shop2007/MAK-NANO2RL-107/IN CONTENITORE METALLICO 114X65.jpg

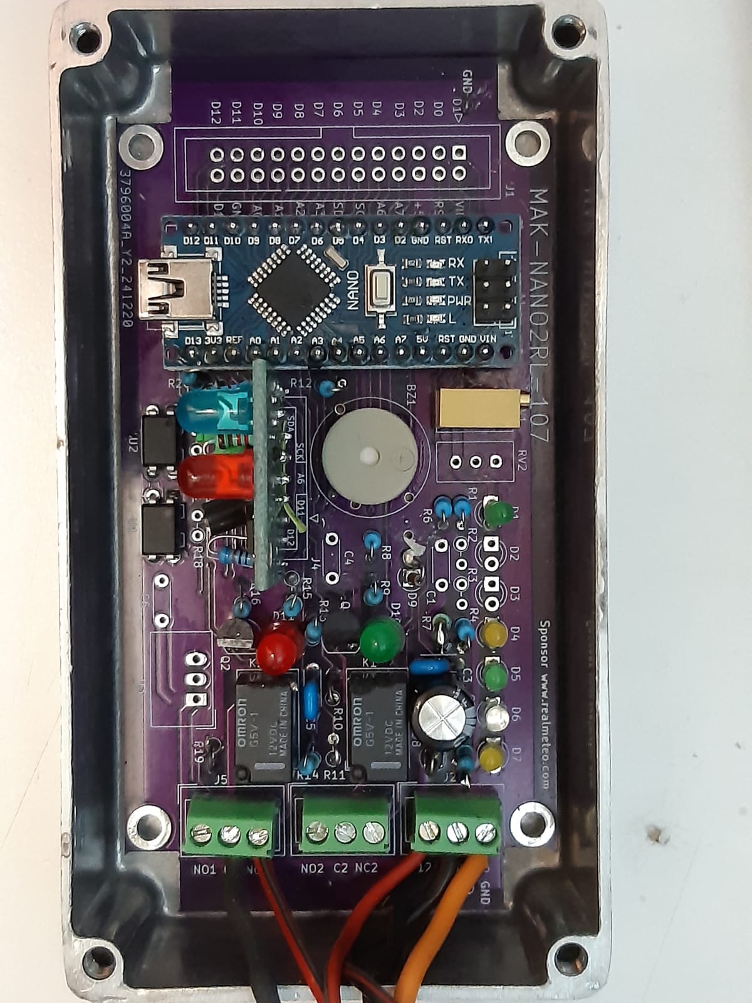
IN CONTENITORE METALLICO 114X65.jpg
