shop2007/MAK-NANO2RL-107/MKR-NANO2RL-107-2.jpg

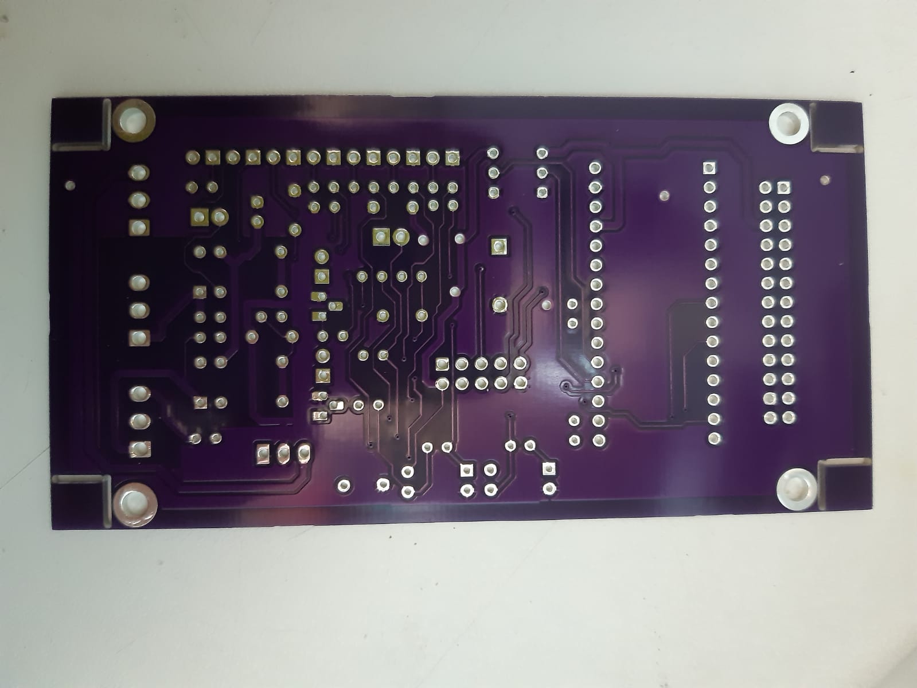
MKR-NANO2RL-107-2.jpg
