shop2007/MAK-NANO2RL-107/README.md

# MAK-NANO2RELE-107

Il pcb **MAK-NANO2RELE-107** è stato pensato per colmare una mancanza nel mondo delle BREAK-OUT, 
una scheda che consenta ai **MAKERS**, di realizzare piccoli sistemi senza dover cablare troppi pezzi, 
quali un Arduino **NANO**, una scheda con **2 RELE** con bobina isolata da fotoaccoppiatori, una scheda per il 5v, 
un buzzer, un modulo WATCHDOG32, ed un sensore di temperatura,con la possibilità di montare tutto su un supporto portaschede da guida din, standard **107** mm.
E' presente anche un connettore di tipo FLAT-CABLE dove possiamo trovare tutti i pin di NANO, per altre espansioni e connessioni
