shop2007/MAK-NANO2RL-107/immagini/1s-l1600.png

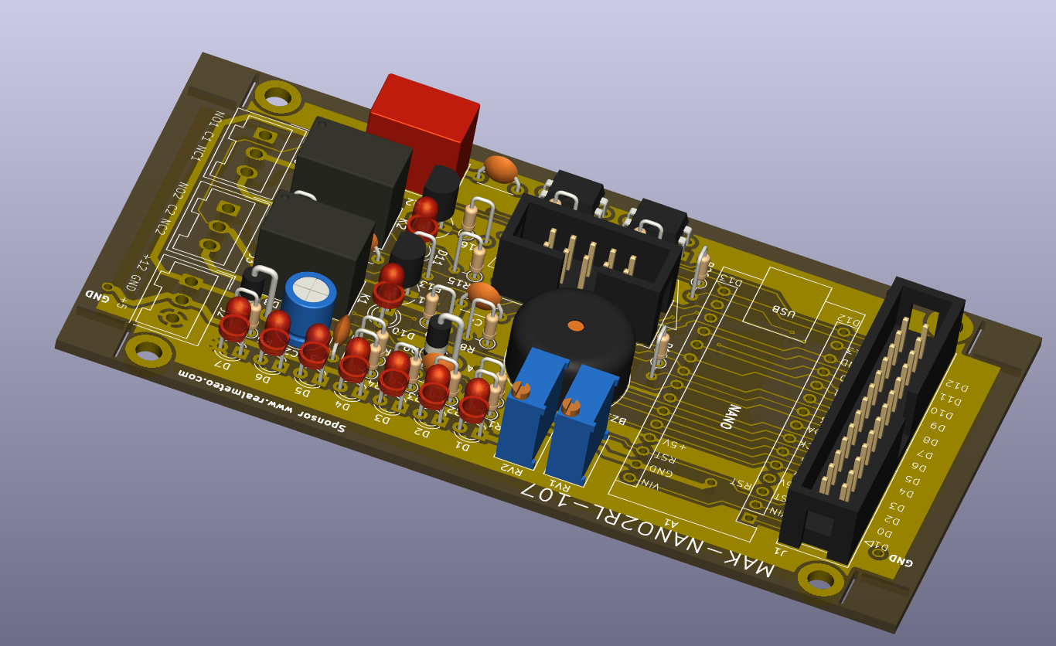
immagini/1s-l1600.png
