shop2007/MAK-NANO2RL-107/immagini/2s-l1600.png

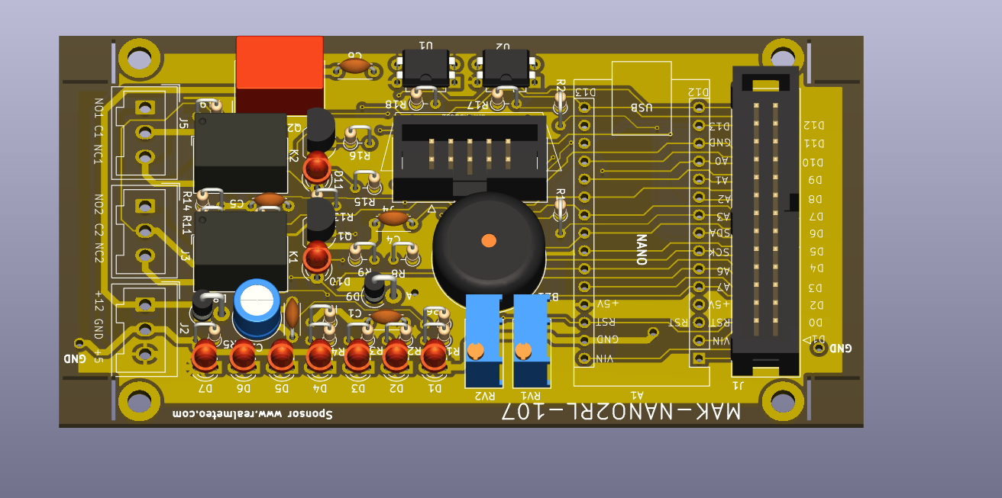
immagini/2s-l1600.png
