shop2007/MAK-NANO2RL-107/immagini/3s-l1600.png

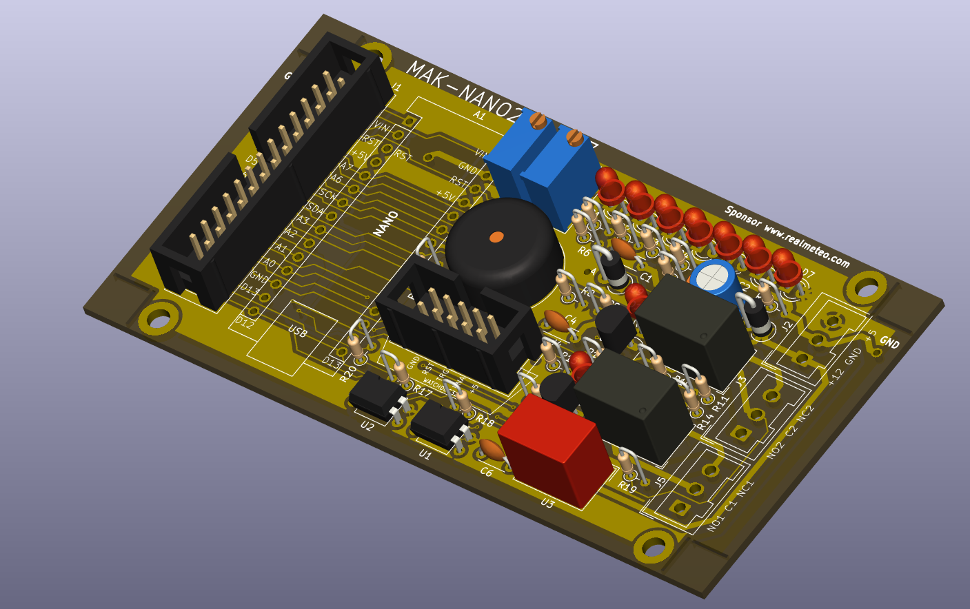
immagini/3s-l1600.png
