shop2007/MAK-NANO2RL-107/immagini/4s-l1600.png

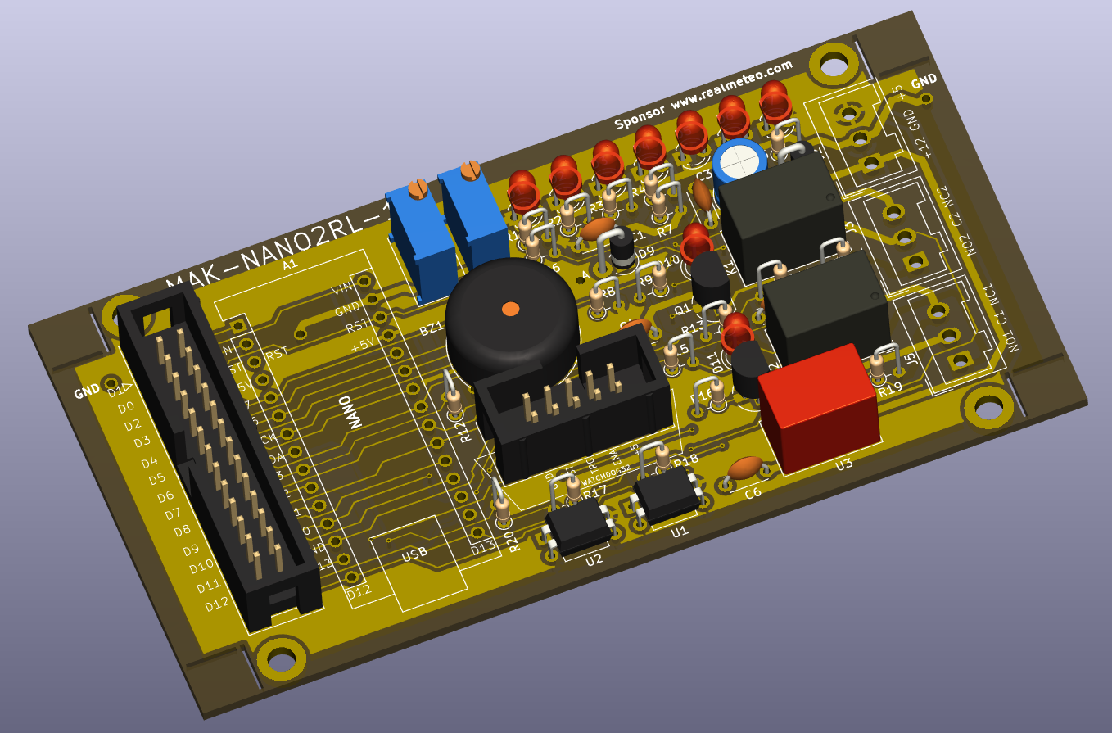
immagini/4s-l1600.png
