shop2007/MAK-NANO2RL-107/immagini/6s-l1600.png

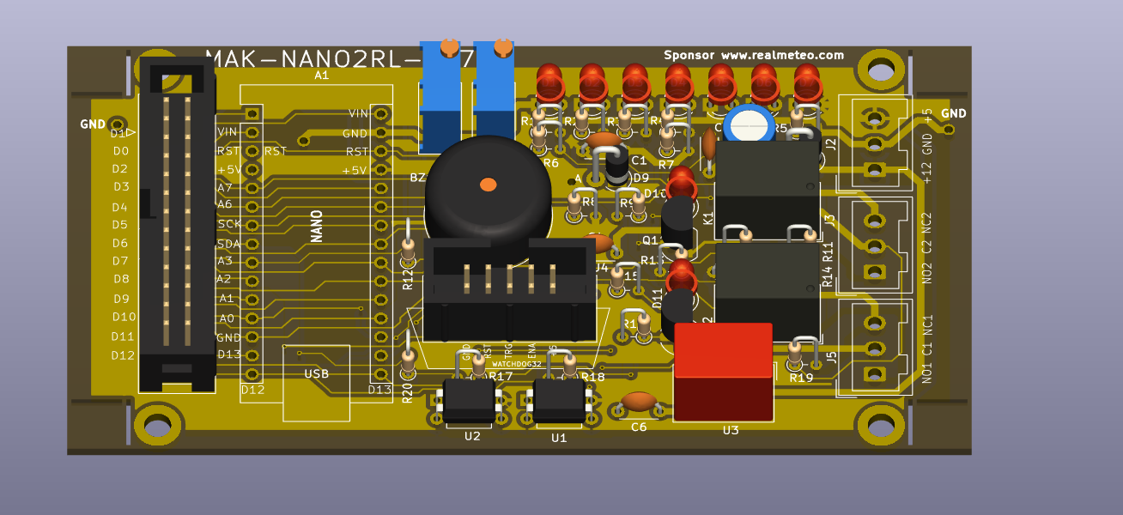
immagini/6s-l1600.png
