shop2007/MAK-NANO2RL-107/immagini/7s-l140.jpg

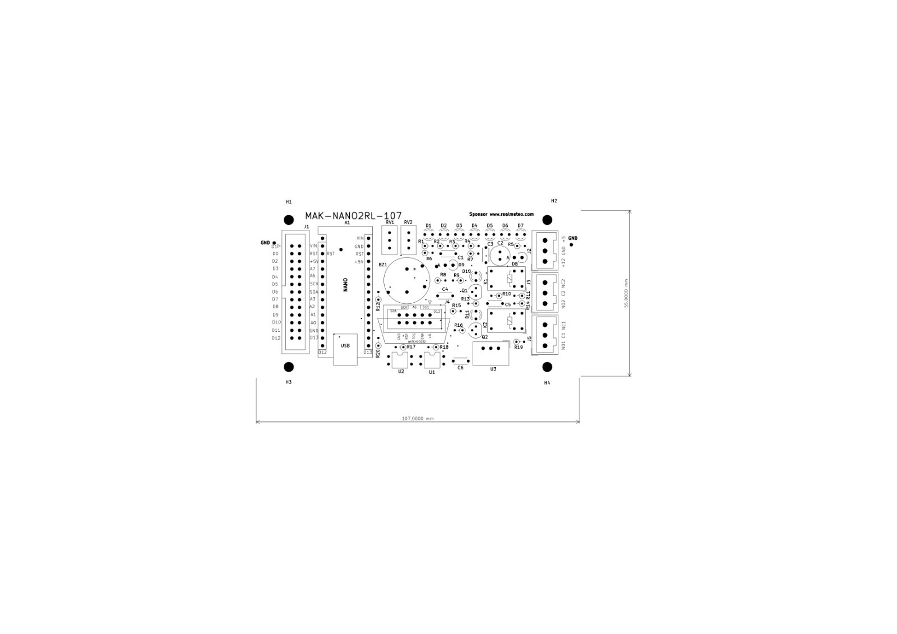
immagini/7s-l140.jpg
