shop2007/MAK-NANO2RL-107/immagini/86s-l1600.png

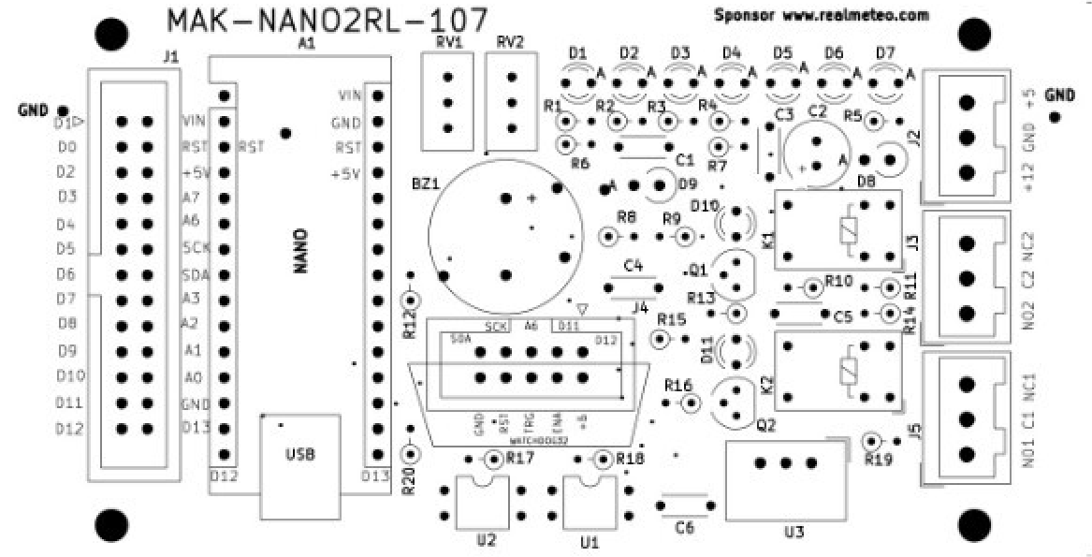
immagini/86s-l1600.png
