shop2007/MAK-NANO2RL-107/MAK-NANO2RL-107_schematic_kicad.pdf.jpg.png

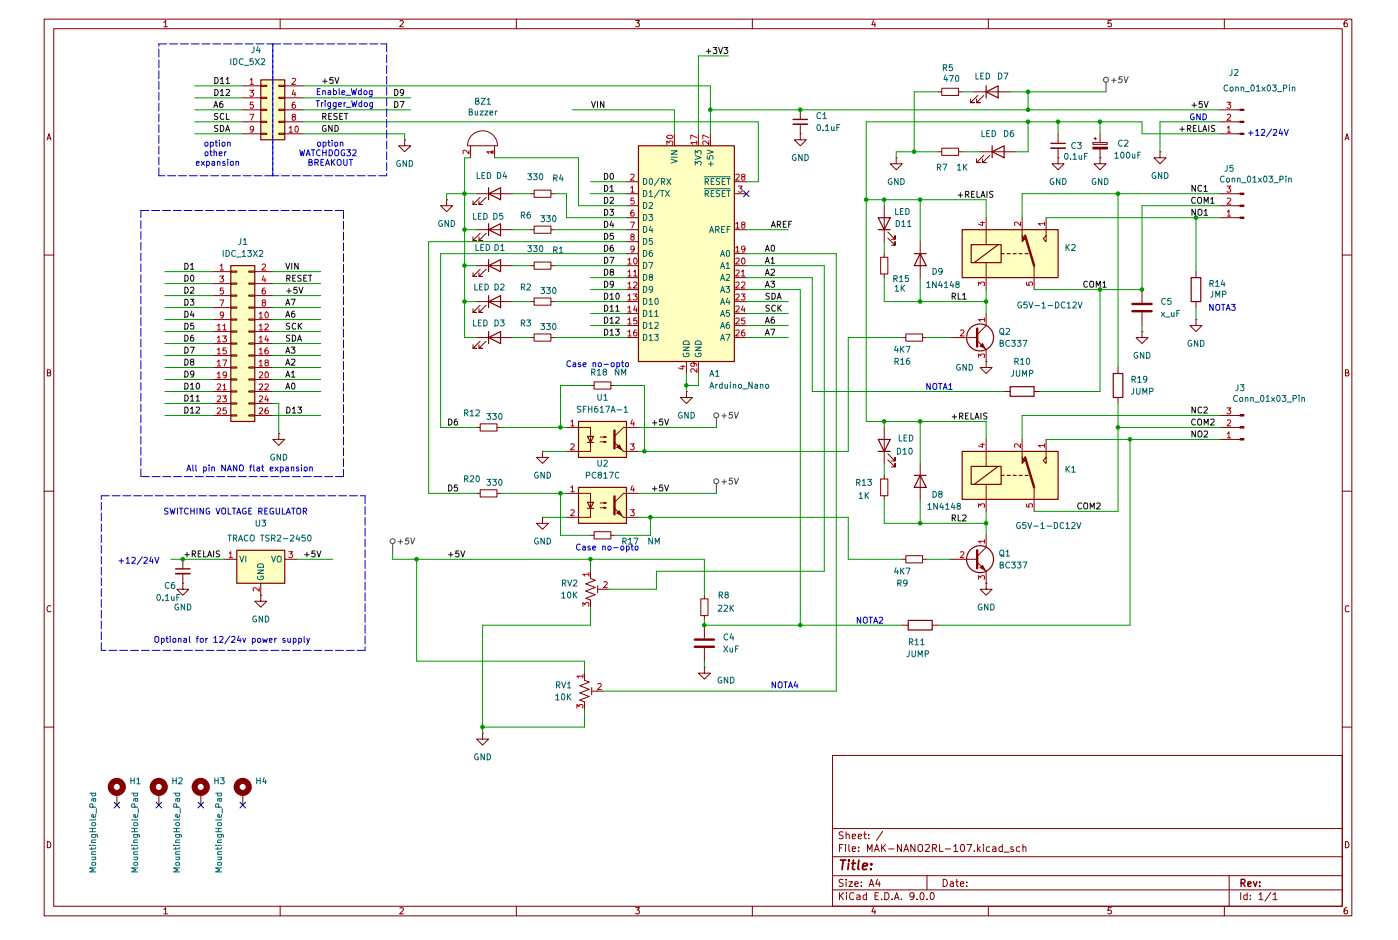
MAK-NANO2RL-107_schematic_kicad.pdf.jpg.png
