shop2007/MAK-NANO2RL-107/Rele-12v-3a-spdt-hk4100f-dc12v-shg.jpg

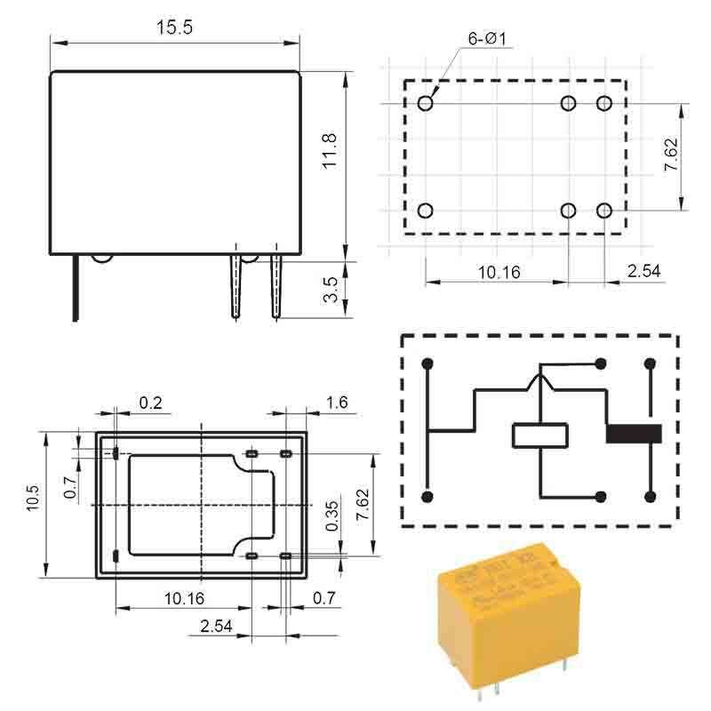
Rele-12v-3a-spdt-hk4100f-dc12v-shg.jpg
