shop2007/MAK-NANO2RL-107/watchdog32_breakout.jpg

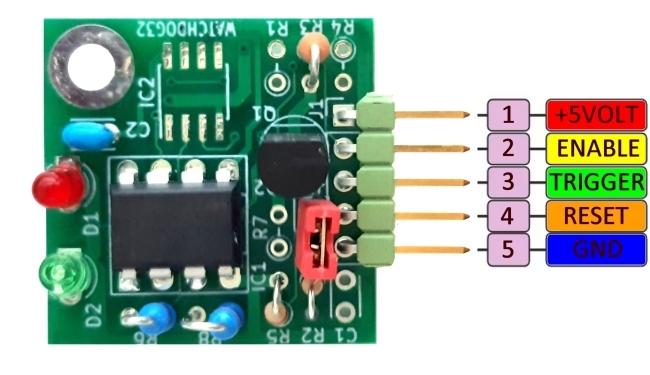
watchdog32_breakout.jpg
