shop2007/MAK-NANO2RL-107/MAK_NANO2RL-bom.xlsx

Reference | Value | Datasheet | Note | Qty | DNP
A1 | Arduino_Nano_v3.x | http://www.mouser.com/pdfdocs/Gravitech_Arduino_Nano3_0.pdf |  | 1
BZ1 | Buzzer | ~ |  | 1
C1,C3,C6 | 0.1uF | ceramico 50v |  | 3
C2 | 100uF | 35v |  | 1
C4 | XuF | 35v | Filtro opzionale | 1
C5 | 1uF | 35v |  | 1
D1,D2,D3,D4,D5,D6,D7,D10,D11 | LED | 3mm | colori vari da 3mm | 9
D8,D9 | 1N4148 | https://assets.nexperia.com/documents/data-sheet/1N4148_1N4448.pdf |  | 2
H1,H2,H3,H4 | Vite+dado M3 | ~ | Fissaggio colonnini | 4
J1 | Conn_02x13_Odd_Even | flat 13x2 | Ripete tutti i segnali di NANO | 1
J2,J3,J5 | Conn_01x03_Pin | Sourcingmap ZB350 AC300 V 10 A 3p passo 3.5 mm PCB morsettiera a vite |  | 3
J4 | Conn_02x05_Odd_Even | flat 5x2 | In alternativa alla WatchDog32 board | 1
K1,K2 | G5V-1 DC12 | http://www.hsinda.com.tw/upload/file/Y14-20200430135145.pdf |  | 2
Q1,Q2 | BC337 | https://diotec.com/tl_files/diotec/files/pdf/datasheets/bc337.pdf |  | 2
R1,R2,R3,R4,R6,R12,R20 | 330 | 1/4watt |  | 7
R5 | 470 | 1/4watt |  | 1
R7,R13,R15 | 1K | 1/4watt |  | 3
R8 | 22K | 1/4watt |  | 1
R9,R16 | 4K7 | 1/4watt |  | 2
R10,R11,R19 | JUMP | 1/4watt | montare se necessario | 3
R14 | JMP | 1/4watt |  | 1
R17,R18 | NM | 1/4watt | installare in alternativa agli opto U1 U2 | 2
RV1,RV2 | R_Potentiometer_Trim_US | Trimmer tarature varie, soglie |  | 2
U1,U2 | SFH617A-1 | http://www.vishay.com/docs/83740/sfh617a.pdf | opto comando relais | 2
U3 | TRACO TSR2-2450 | https://www.onsemi.cn/PowerSolutions/document/MC7800-D.PDF | regolatore switching 5v | 1
Box 120x65x40
