shop2007/MAK-NANO2RL-107/Montaggio scheda MAK-NANO2RL-107.docx

Montaggio scheda MAK-NANO2RL-107

Schema elettrico

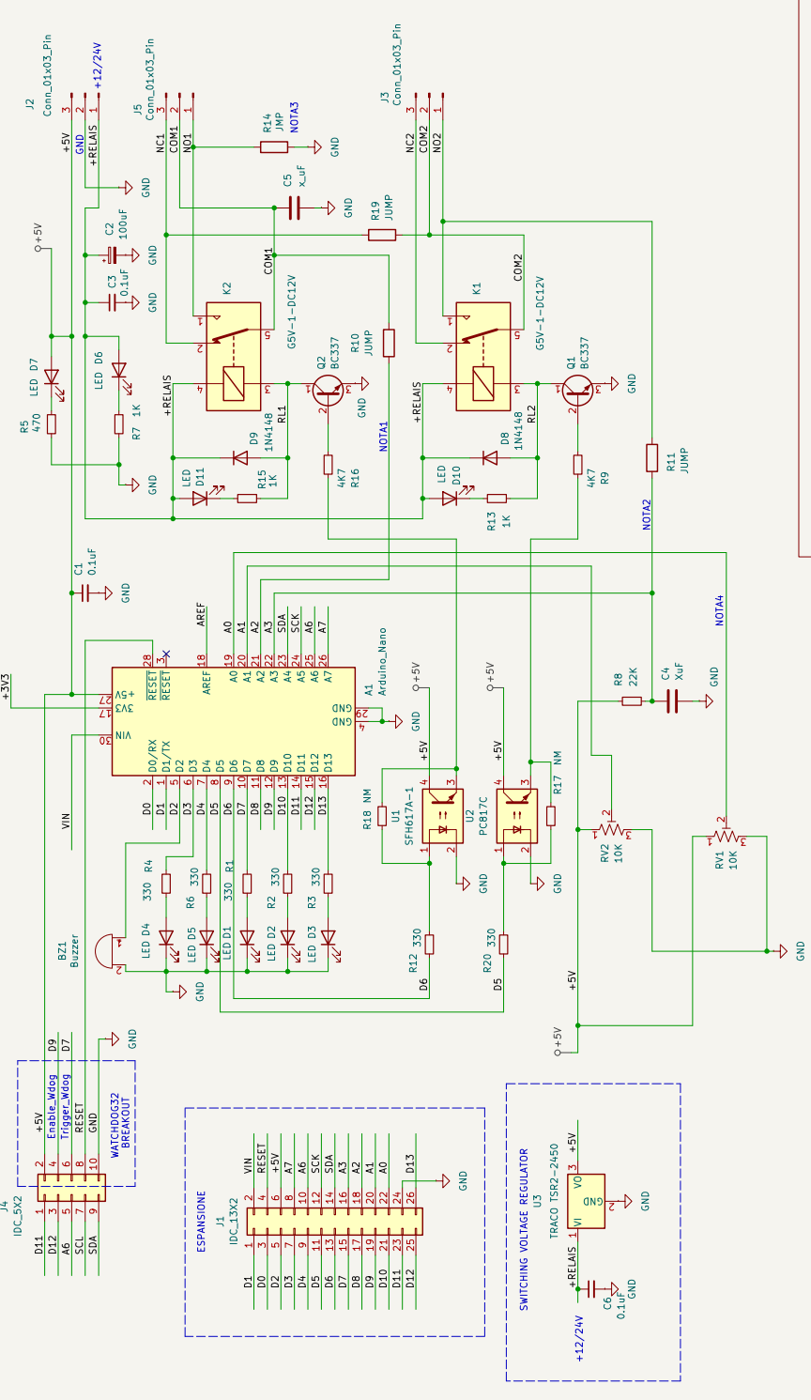
[picture p13: figure]
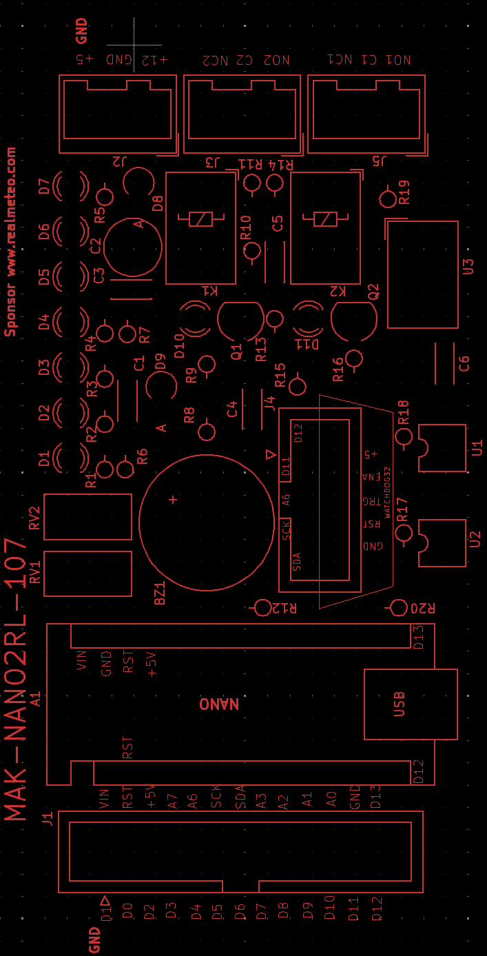
[picture p14: figure]

Reference | Value | | Footprint
A1 | Arduino_Nano | | Module:Arduino_Nano
BZ1 | Buzzer | | Buzzer_Beeper:Buzzer_15x7.5RM7.6
C1,C3,C6 | 0.1uF | | Capacitor_THT:C_Disc_D4.3mm_W1.9mm_P5.00mm
C2 | 100uF | | Capacitor_THT:C_Radial_D6.3mm_H7.0mm_P2.50mm
C4 | XuF optional | | Capacitor_THT:C_Disc_D4.3mm_W1.9mm_P5.00mm
C5 | 1uF optional | | Capacitor_THT:C_Disc_D4.3mm_W1.9mm_P5.00mm

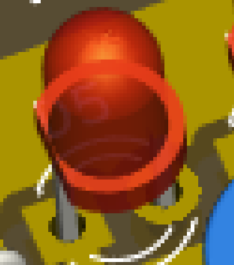
[picture p15: figure]

D1,D2,D3,D4,D5,D6, D7,D10,D11 | LED colori vari | | LED_THT:LED_D3.0mm Anodo pad tondo Katodo pad quadro

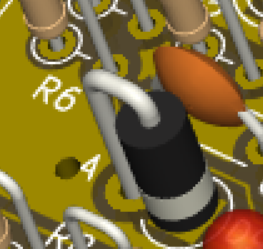
[picture p16: figure]

D8,D9 | 1N4148 | | Diode_THT:D_DO-41_SOD81_P2.54mm_Vertical_AnodeUp Anodo pad tondo Katodo pad quadro
H1,H2,H3,H4 | Vite+dado M3 | | MountingHole:MountingHole_3.2mm_M3_DIN965_Pad
J1 | Conn_02x13_ IDC | | Connector_IDC:IDC-Header_2x13_P2.54mm_Vertical
J2,J3,J5 | Conn_01x03_Pin | | Connector_Wago:Wago_734-133_1x03_P3.50mm_Vertical
J4 | Conn_02x05_ IDC WATCHDOG32 | | Connector_IDC:IDC-Header_2x05_P2.54mm_Vertical
K1,K2 | G5V-1 DC12 | | Relay_THT:Relay_SPDT_HsinDa_Y14 Y14x-1C-xxDS

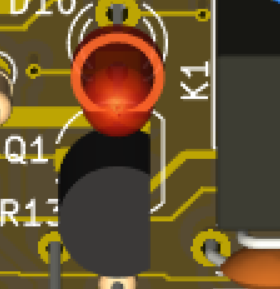
[picture p17: figure]

Q1,Q2 | BC337 | | Package_TO_SOT_THT:TO-92_
R1,R2,R3,R4,R6, R12,R20 | 330 - 1/4W | | Resistor_THT:R_Axial_DIN0204_L3.6mm_D1.6mm_P2.54mm_Vertical
R5 | 470 - 1/4W | | Resistor_THT:R_Axial_DIN0204_L3.6mm_D1.6mm_P2.54mm_Vertical
R7,R13,R15 | 1K - 1/4W | | Resistor_THT:R_Axial_DIN0204_L3.6mm_D1.6mm_P2.54mm_Vertical
R8 | 22K - 1/4W | | Resistor_THT:R_Axial_DIN0204_L3.6mm_D1.6mm_P2.54mm_Vertical
R9,R16 | 4K7 - 1/4W | | Resistor_THT:R_Axial_DIN0204_L3.6mm_D1.6mm_P2.54mm_Vertical
R10,R11,R19 | JUMP Optional | | Resistor_THT:R_Axial_DIN0204_L3.6mm_D1.6mm_P2.54mm_Vertical
R14 | JUMP Optional | | Resistor_THT:R_Axial_DIN0204_L3.6mm_D1.6mm_P2.54mm_Vertical
R17,R18 | N.M. Short opto | | Resistor_THT:R_Axial_DIN0204_L3.6mm_D1.6mm_P2.54mm_Vertical
RV1,RV2 | Trimmer 10K | | Potentiometer_THT:Potentiometer_Bourns_3296W_Vertical

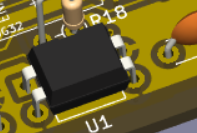
[picture p18: figure]

U1,U2 | SFH617A-1 PC817C | | Package_DIP:DIP-4_W7.62mm
U3 | TRACO TSR2-2450 optional | | Converter_DCDC:Converter_DCDC_TRACO_TSR-1_THT
Box 120x65x40 | box

BUZZER | PORT D2
LED D1 | PORT D7
LED D2 | PORT D10
LED D3 | PORT D13
LED D4 | PORT D3
LED D5 | PORT D4
LED D6 | SPIA +12v
LED D7 | SPIE +5v
LED D10 | SPIA RELAY NC/COM/NO2
LED D11 | SPIA RELAY NC/COM/NO1
A0 | TRIMMER 1
A1 | TRIMMER2
A2 | LETTURA COM1 (R10)
A3 | LETTURA NO2 (R11)
A4 | SDA
A5 | SCL
TRIGGER WATCHDOG32 | PORT D7
ENABLE WATCHDOG32 | PORT D9
