shop2007/MAK-NANO2RL-107/MAK_NANO2RELE piano di montaggio..png

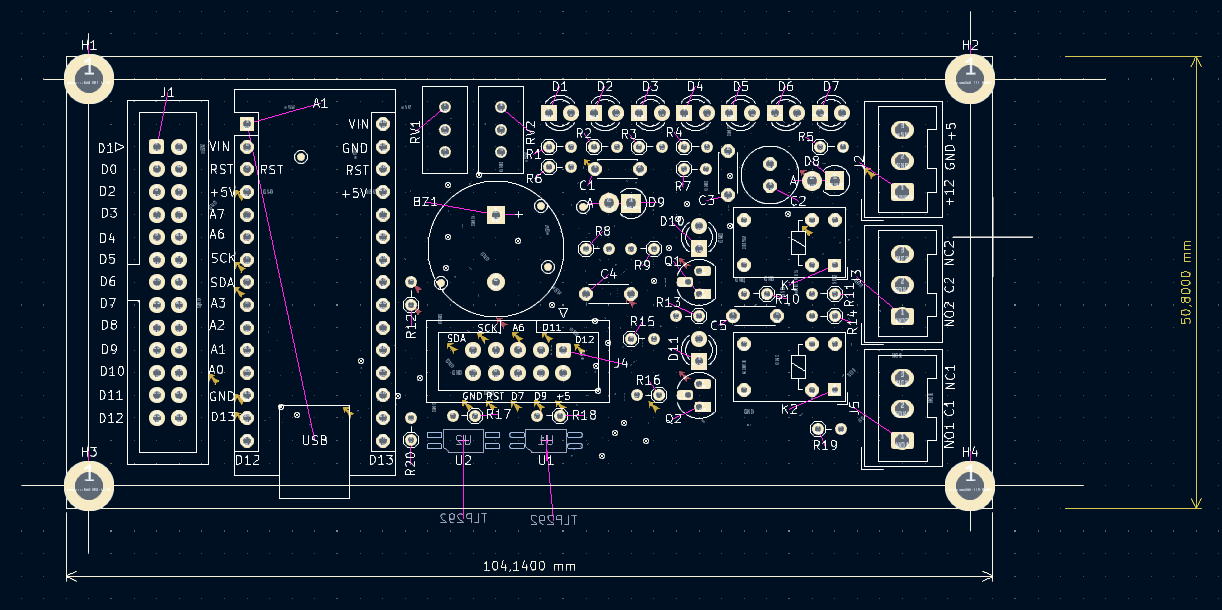
MAK_NANO2RELE piano di montaggio..png
