shop2007/MAK-NANO2RL-107/MAK-NANO2RL-107_schematic_kicad.pdf

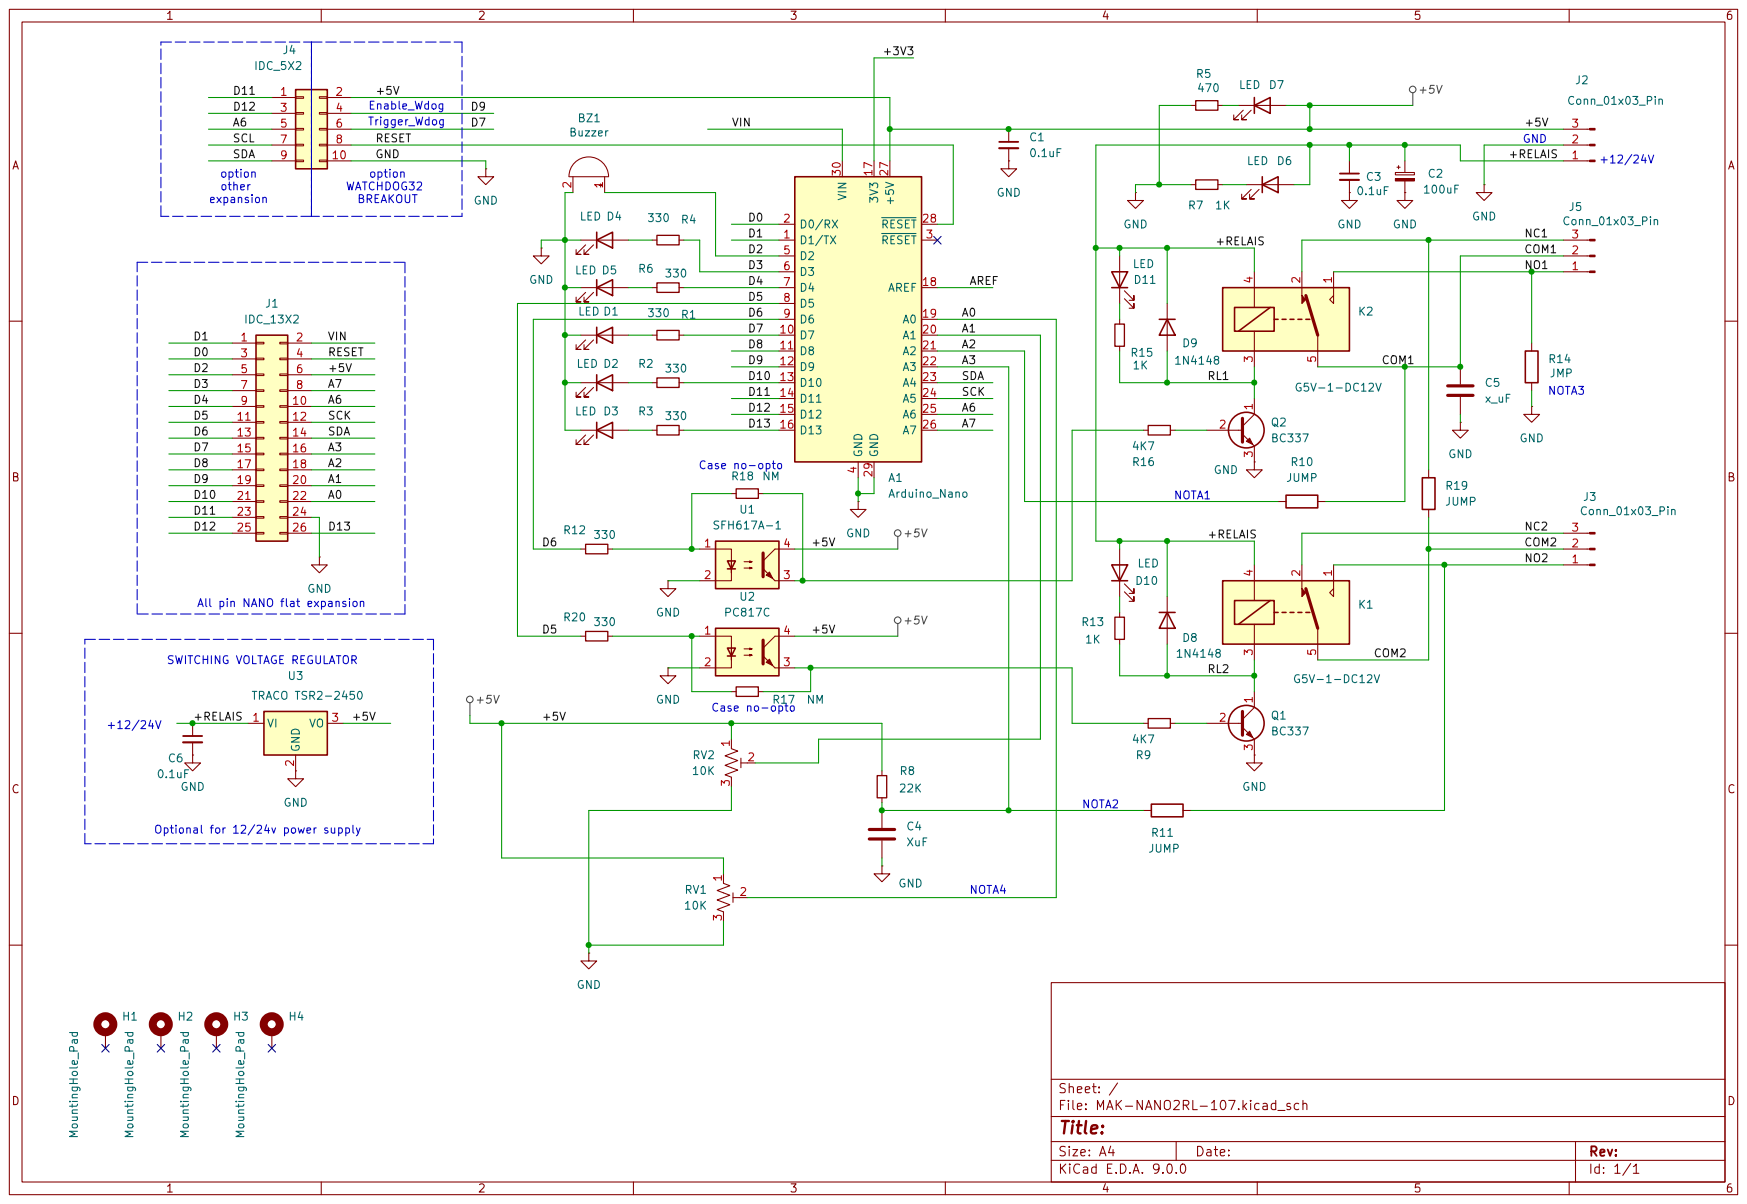
[picture p20: page 1]
