shop2007/MAK-NANO2RL-107/Contenitore RND in Lega di alluminio 115 x 65 x 30mm.pdf

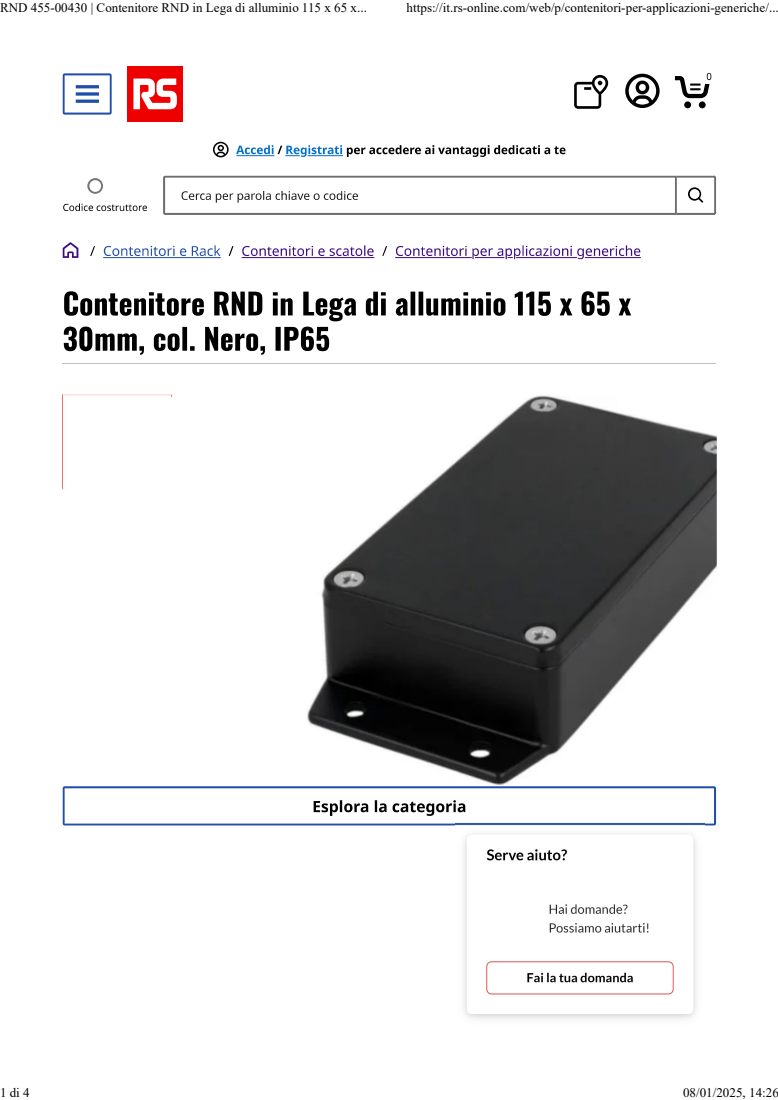
[picture p21: page 1]
RND 455-00430 | Contenitore RND in Lega di alluminio 115 x 65 x...; https://it.rs-online.com/web/p/contenitori-per-applicazioni-generiche/...

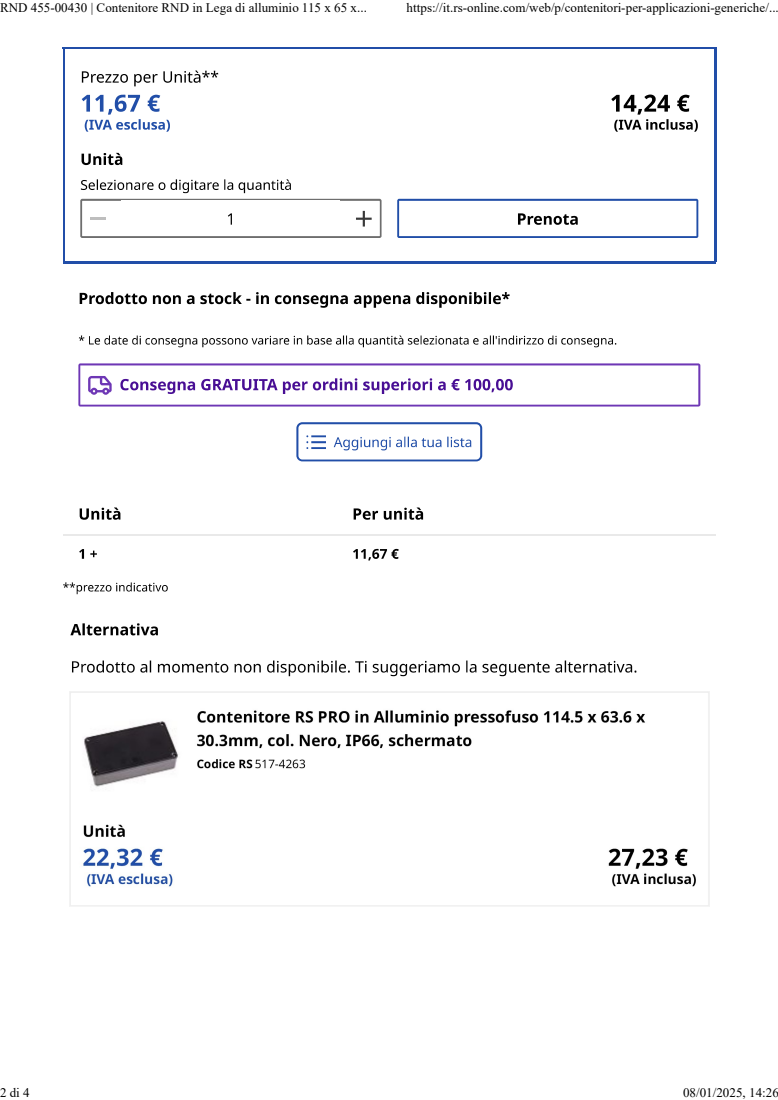
[picture p22: page 2]

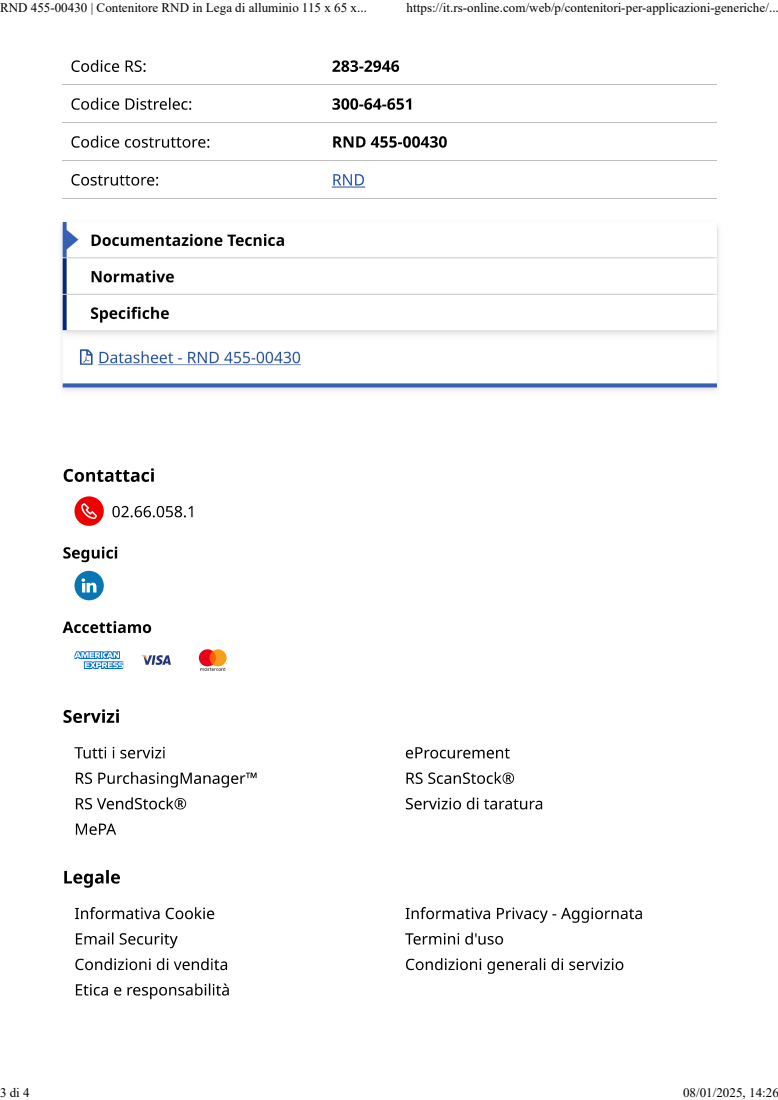
[picture p23: page 3]

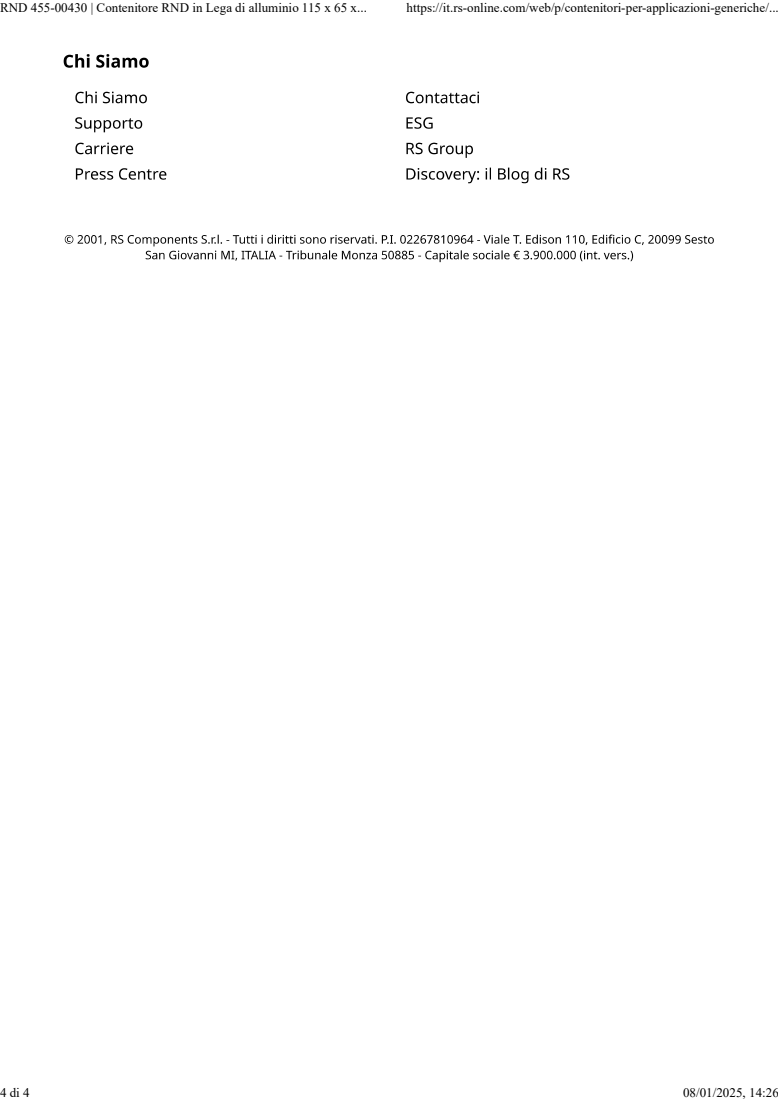
[picture p24: page 4]
